rimio/ghetto-cw-keyer/Circuit/Keyer.pdf

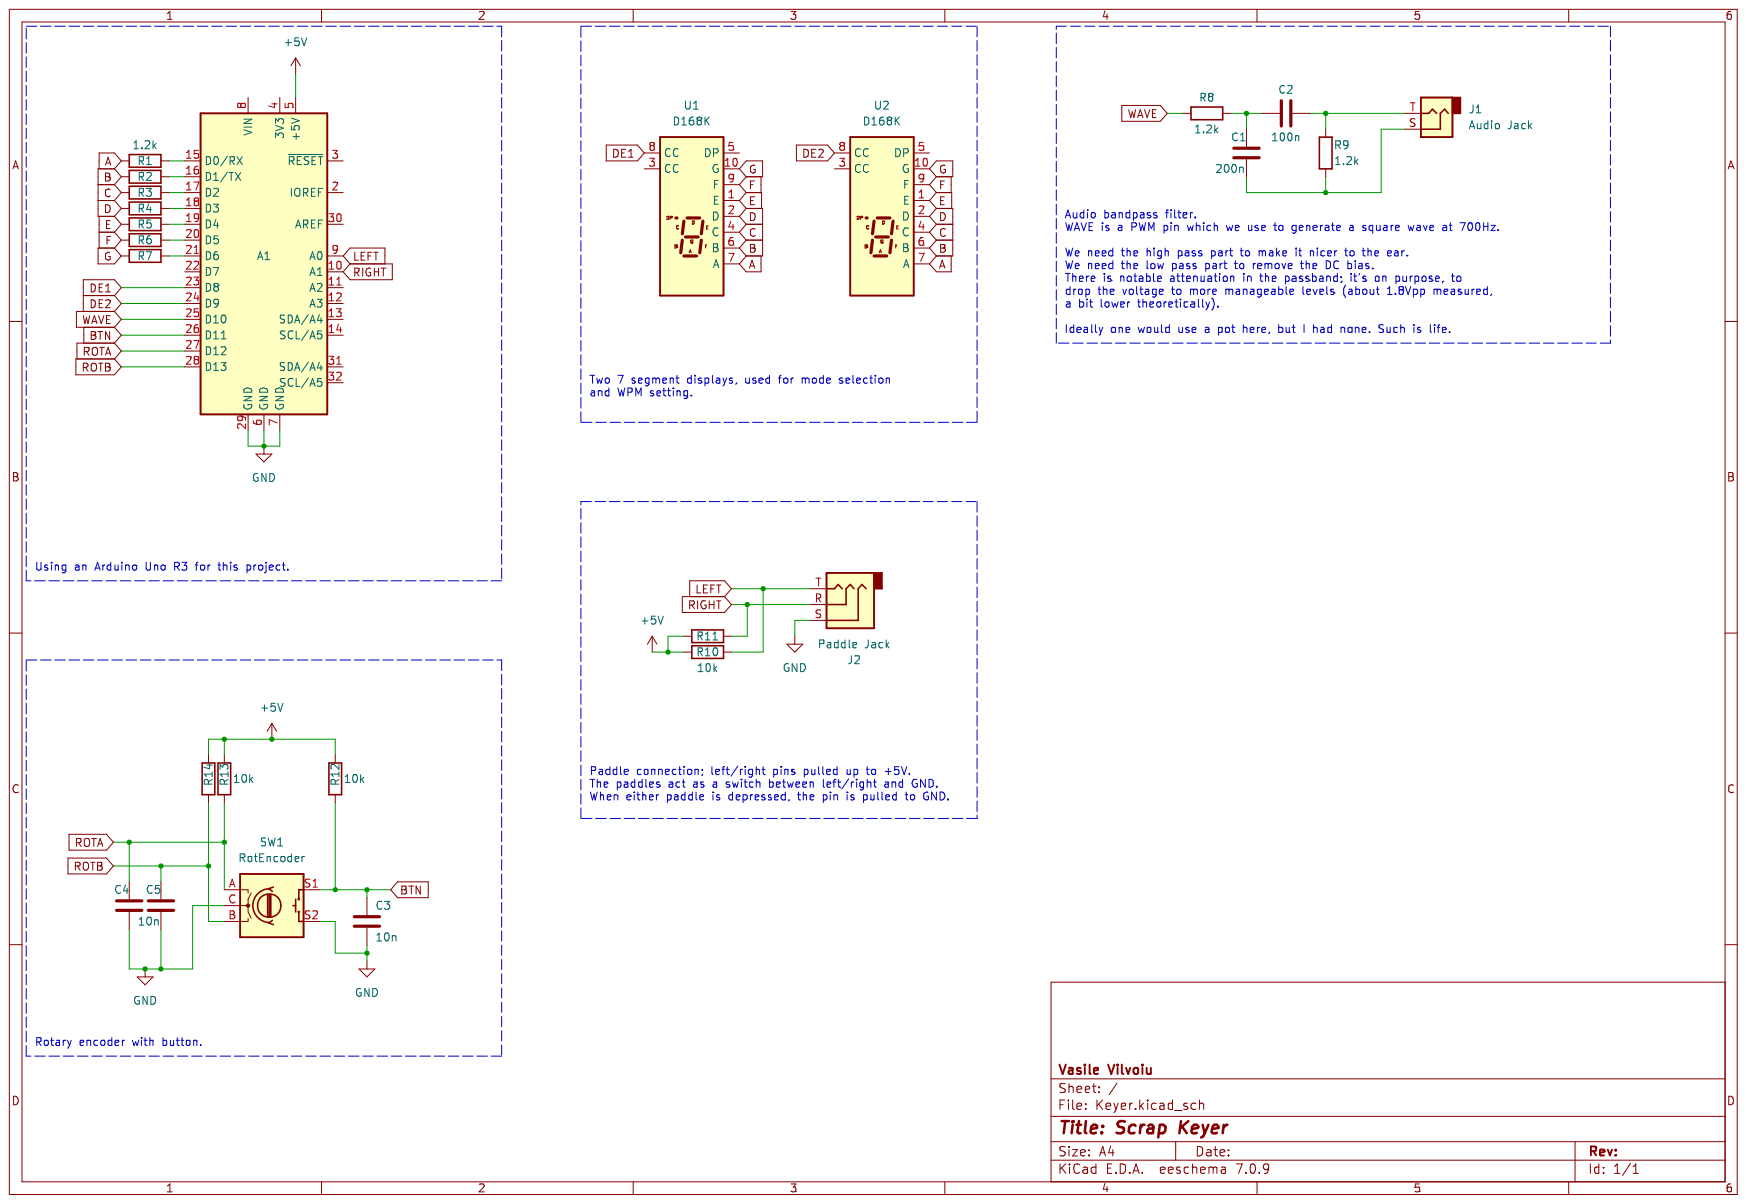
[picture p1: page 1]
