rimio/ghetto-cw-keyer/Circuit/Keyer.kicad_sch

## KiCad design Circuit/Keyer.kicad_sch (2024-01-04)

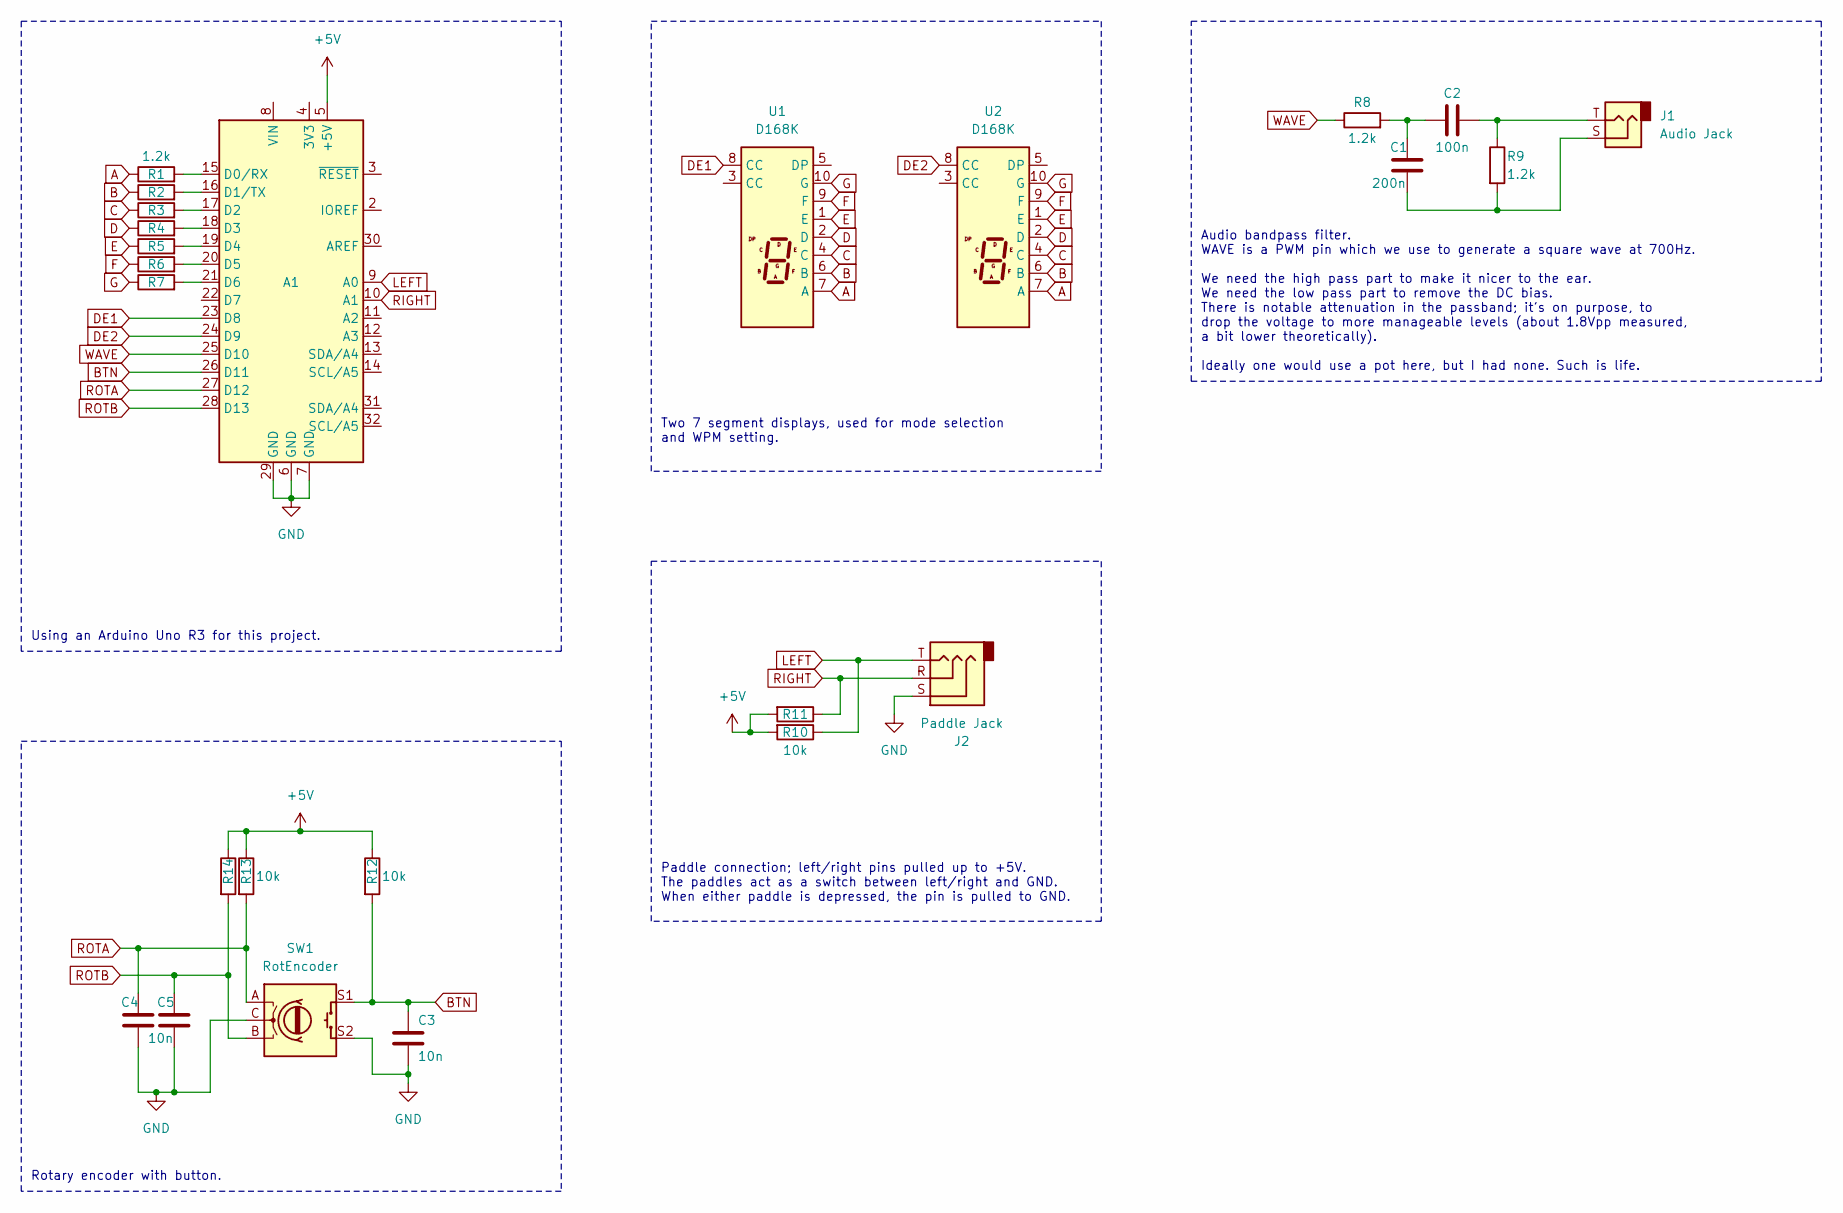
[picture p2: schematic Keyer.kicad_sch]

Parts:
A1: Arduino_UNO_R3
C1: 200n
C2: 100n
C3, C4, C5: 10n
J1: Audio Jack
J2: Paddle Jack
R1, R2, R3, R4, R5, R6, R7, R8, R9: 1.2k
R10, R11, R12, R13, R14: 10k
SW1: RotEncoder
U1, U2: D168K; D1X8K

Connections:
+5V: A1.5 (+5V), R10.2, R11.2, R12.1, R13.1, R14.1
A: R1.1, U1.7 (A), U2.7 (A)
B: R2.1, U1.6 (B), U2.6 (B)
BTN: A1.26 (D11), C3.1, R12.2, SW1.S1
C: R3.1, U1.4 (C), U2.4 (C)
D: R4.1, U1.2 (D), U2.2 (D)
DE1: A1.23 (D8), U1.8 (CC)
DE2: A1.24 (D9), U2.8 (CC)
E: R5.1, U1.1 (E), U2.1 (E)
F: R6.1, U1.9 (F), U2.9 (F)
G: R7.1, U1.10 (G), U2.10 (G)
GND: A1.6 (GND), A1.7 (GND), A1.29 (GND), C3.2, C4.2, C5.2, J2.S, SW1.C, SW1.S2
LEFT: A1.9 (A0), J2.T, R10.1
unnamed: A1.15 (D0/RX), R1.2
unnamed: A1.16 (D1/TX), R2.2
unnamed: A1.17 (D2), R3.2
unnamed: A1.18 (D3), R4.2
unnamed: A1.19 (D4), R5.2
unnamed: A1.20 (D5), R6.2
unnamed: A1.21 (D6), R7.2
unnamed: C1.1, C2.1, R8.2
unnamed: C1.2, J1.S, R9.2
unnamed: C2.2, J1.T, R9.1
RIGHT: A1.10 (A1), J2.R, R11.1
ROTA: A1.27 (D12), C4.1, R13.2, SW1.A
ROTB: A1.28 (D13), C5.1, R14.2, SW1.B
WAVE: A1.25 (D10), R8.1

Notes on the sheet:
Audio bandpass filter. WAVE is a PWM pin which we use to generate a square wave at 700Hz. We need the high pass part to make it nicer to the ear. We need the low pass part to remove the DC bias. There is notable attenuation in the passband; it's on purpose, to drop the voltage to more manageable le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
Two 7 segment displays, used for mode selection and WPM setting.
Using an Arduino Uno R3 for this project.
Paddle connection; left/right pins pulled up to +5V. The paddles act as a switch between left/right and GND. When either paddle is depressed, the pin is pulled to GND.
Rotary encoder with button.
