rimio/ghetto-cw-keyer/(commit log)

2024-01-04 Code and circuit.
    [Keyer.kicad_sch]
2024-01-05 Restructure files.
    [Keyer.kicad_sch]
2024-01-05 Fix int timers.
